npu-ius-lab/open32drone/docs/project/third-party.md

# Third-party notices

Original Open32Drone code and documentation use **Apache License 2.0** by default. See [LICENSE](../../LICENSE) for the full terms and [LICENSE.txt](../../LICENSE.txt) for the scope. Third-party code, dependencies and media retain their original licenses and copyright notices.

## Software and dependencies

| Component | Source and license |
|---|---|
| Flight-control core | Derived from Oleg Kalachev's [Flix](https://github.com/okalachev/flix). |
| ROS 2 driver | MIT; see [ros2/package.xml](../../ros2/package.xml). |
| IMU/SBUS library | FlixPeriph 1.10.4, used under its upstream license; fetched as a build dependency and not bundled with this repository. |
| MAVLink communication | MAVLink Arduino 2.0.25 and ROS MAVROS, each under its own license. |
| Development tools and runtime dependencies | Arduino-ESP32, Android/Gradle, Vue/VitePress, PyTorch and Isaac Sim, each under its own license. |

## Hardware resource pages

| Resource | Source and license information |
|---|---|
| Frame print profile | [MakerWorld](https://makerworld.com.cn/zh/models/2922108-open32drone-wu-ren-ji-8520kong-xin-bei-ji-jia-ros2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): the page lists CC BY-NC 4.0. Retain attribution and follow the model's terms. |
| PCB design | [JLC Open Hardware](https://oshwhub.com/fanchewang/open32drone): the page lists MIT License and also includes platform notices about redistribution and non-commercial use. Check the project files and platform terms before use. |
