npu-ius-lab/open32drone/docs/index.md

---
layout: doc
aside: false
prev: false
next: false
pageClass: documentation-index
title: 文档与更新
description: Open32Drone 制作教程、开发参考和公开仓库更新记录。
---

<script setup>
import DocumentationHome from './.vitepress/theme/components/DocumentationHome.vue'
</script>

<DocumentationHome />
