npu-ius-lab/open32drone/hardware/assets/pwa-1.4x4x4-screws-12pcs.png

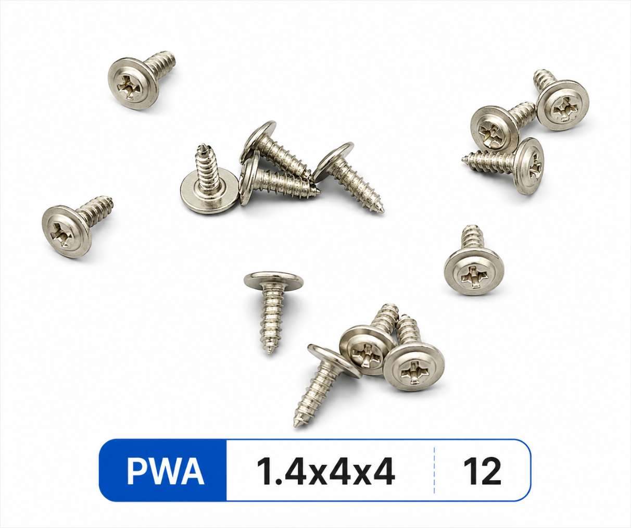
hardware/assets/pwa-1.4x4x4-screws-12pcs.png
