npu-ius-lab/open32drone/hardware/3d-model/open32drone-frame.stp

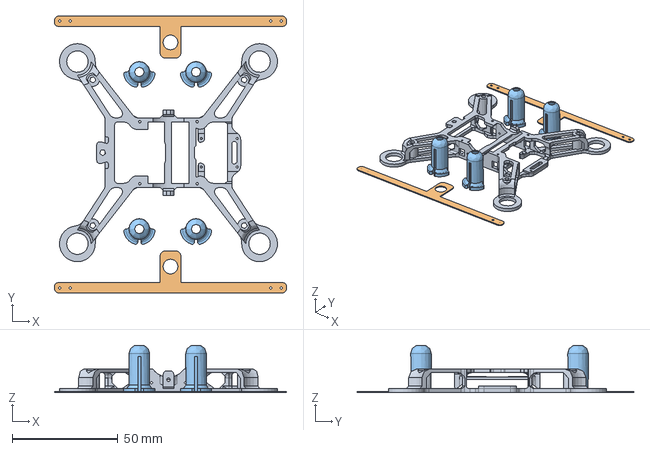
[picture p36: CAD file, 2026-09-30]
hardware/3d-model/open32drone-frame.stp
110.0 x 131.2 x 22.3 mm
