npu-ius-lab/open32drone/(list of files, cad)

Other CAD files:
hardware/3d-model/open32drone-frame.3mf
