npu-ius-lab/open32drone/docs/guide/07-rl.md

# 06 · 强化学习

上一章通过 ROS 读取飞机状态、发送控制目标，再根据传感器反馈调整动作。这一章在仿真中练习强化学习，让策略经过反复训练，学习应对风扰、动力差异和模型误差。

本项目采用残差强化学习：几何 PD 控制器负责稳定姿态、分配四路电机输出，PPO 网络给出三轴加速度修正。对于这架 81 g 的微型飞机，这样安排可以保留基础控制器中明确的物理关系，让策略主要学习传统模型难以描述的扰动和误差。

## 6.1 先把真实飞机变成机器人模型

仓库中的数值模型和 PPO 练习可以直接运行，但不包含完整飞机的 URDF/USD 场景、Gazebo 飞行后端和预训练权重。下面用参考结构和仿真视频说明建模方式，曲线也来自仿真。没有另外准备场景时，从 6.4 的 CPU 练习开始，不要直接执行 Isaac 命令。

参考 URDF/USD 模型使用一个刚性机身和四个旋翼关节：

参考模型层级

`base_link` 包含不会相对机身运动的主体：打印机架、主控 PCB、XIAO、橡胶圈、电机外壳、供电与固定结构。IMU 和光流/ToF 都有固定坐标系，方便 ROS 和仿真传感器引用；它们的实体质量已计入刚性机身。电池单独保留 `battery_link`，便于更换质量或位置；相机也是固定 link；四副桨叶各自是一个 `continuous` link。

参考模型的质量分配为：

| 部分 | 质量 |
| --- | ---: |
| 刚性机身 `base_link` | 54.2547 g |
| 4 副桨叶 | 约 1.4542 g |
| 18350 电池 | 25.0000 g |
| 相机 | 约 0.2911 g |
| 合计 | 81.0000 g |

下面的视频把四段 Isaac Sim 检查合在一起：外观与 81 g 配置、主控 PCB 近景、无动力自由落体、四个旋翼关节运动。

<video class="guide-video" controls preload="metadata" playsinline poster="/media/figures/model-checks-poster.png">
  <source src="/media/videos/model-checks.mp4" type="video/mp4">
</video>

## 6.2 没有完整电机曲线，怎样先建立模型

8520 电机只给出尺寸和最高 50,000 rpm，不能直接得到带 60 mm 桨时的推力。最高转速换算为角速度是：

```text
50,000 × 2π ÷ 60 = 5,235.99 rad/s
```

这个数可以用来设置关节速度上限，但不能当作实际带桨转速或推力。可以先根据真实飞机悬停时的受力估算：

```text
单电机平均悬停推力
= 总质量 × 重力加速度 ÷ 4
= 0.081 kg × 9.80665 m/s² ÷ 4
≈ 0.1986 N
≈ 20.25 gf
```

再从记录了电压的日志中，读取稳定悬停时四路电机命令的平均值。参考日志约为 47.4%，粗模型据此外推，得到满命令时约 0.419 N/电机的推力，并取 40 ms 作为电机响应初值。训练时随机改变推力增益、质量、惯量、电压和响应时间，避免策略过度依赖某一组固定参数。

这些粗估值可以先用于训练、评估和 Isaac 展示，不必等厂家提供完整模型。后续可以搭一个简单的单电机推力台，在 4.2、3.9、3.7、3.5 V 下测量多个 PWM 点，再逐步用实测数据替换。

## 6.3 训练任务是什么

悬停练习的观测有 35 维，包含位置/速度误差、姿态矩阵、角速度、参考速度与加速度、上一步动作、误差积分、电机估计力和电压。网络输出 3 维动作，分别是 x、y、z 方向的残差加速度，范围为 `±4 m/s²`。

每个仿真环境都从略有不同的初始姿态、动力参数和风扰开始。策略在每一步得到奖励：

- 接近目标位置与速度；
- 保持姿态和飞行高度；
- 动作平滑，不频繁大幅修正；
- 不发生翻覆、撞地或飞出范围。

PPO 会同时运行多个仿真环境，收集观测、动作和结果，再用这些数据更新策略。训练结束后，换用训练时未见过的随机种子和更强的扰动，比较基础 PD 与 PPO 残差的表现。

## 6.4 在普通电脑上跑第一个 PPO

从仓库根目录创建 Python 环境：

```bash
python3 -m venv .venv
source .venv/bin/activate
python3 -m pip install --upgrade pip
python3 -m pip install numpy torch matplotlib
```

运行 CPU 悬停练习：

```bash
python3 simulation/course/hover_lab.py \
  --output output/my-first-hover \
  --iterations 400 --envs 128 --device cpu
```

输出目录会包含：

| 文件 | 内容 |
| --- | --- |
| `training.csv` | 每轮奖励、位置误差和失败数 |
| `policy_initial.pt` / `policy_final.pt` | 初始与最终策略 |
| `actor.pt` | 可独立加载的 TorchScript 策略 |
| `evaluation.json` | PD 与 PPO 在留出工况中的结果 |
| `config.json` | 训练使用的全部设置 |

参考运行的结果如下，数值是 96 个完整回合的平均 RMS 位置误差：

| 水平扰动 | 基础 PD | PPO 残差 |
| ---: | ---: | ---: |
| 0.0 m/s² | 1.58 cm | 3.64 cm |
| 0.8 m/s² | 16.51 cm | 6.03 cm |
| 1.5 m/s² | 30.48 cm | 10.56 cm |

这次参考运行中，平静环境下的基础 PD 更准确；风扰增强后，PPO 的补偿明显降低了位置误差。残差策略主要处理持续扰动和模型误差，稳定飞行仍由基础控制器负责。

基础 PD 与 PPO 在三种扰动下的位置误差

<p class="figure-caption">图 7-1　CPU 悬停练习的留出工况对比。</p>

PPO 训练曲线

<p class="figure-caption">图 7-2　训练过程中的奖励与误差变化。</p>

## 6.5 从悬停到技巧飞行

除了定点悬停，演示中还安排了连续轨迹：先沿八字曲线穿过 10 个环，再螺旋爬升，最后在阵风中悬停。目标轨迹由程序给出，PPO 负责学习轨迹跟踪和扰动补偿。

先看相同扰动下的固定镜头悬停。第一段是基础 PD，第二段是 PPO 残差：

<div class="video-grid">
  <figure>
    <video class="guide-video" controls preload="metadata" playsinline poster="/media/figures/hover-pd-poster.png">
      <source src="/media/videos/hover-pd.mp4" type="video/mp4">
    </video>
    <figcaption>基础 PD：受到持续扰动后出现较大的稳态偏移。</figcaption>
  </figure>
  <figure>
    <video class="guide-video" controls preload="metadata" playsinline poster="/media/figures/hover-ppo-poster.png">
      <source src="/media/videos/hover-ppo.mp4" type="video/mp4">
    </video>
    <figcaption>PPO 残差 + PD：策略主动补偿扰动并回到目标附近。</figcaption>
  </figure>
</div>

下面是 60 秒完整演示，包括模型、训练流程、悬停对照、八字穿环、螺旋和阵风恢复：

<video class="guide-video" controls preload="metadata" playsinline poster="/media/figures/rl-demo-poster.png">
  <source src="/media/videos/rl-demo-60s.mp4" type="video/mp4">
</video>

Isaac Sim 中的 34 秒连续飞行通过了 10/10 个环，位置 RMS 误差约 12.11 cm，最高速度约 1.10 m/s。独立工况对比如下：

| 工况 | 基础 PD | PPO 残差 + PD |
| --- | ---: | ---: |
| 平静 | 2.72 cm | 8.19 cm |
| 持续扰动 | 51.33 cm | 18.43 cm |
| 电机差异与质量误差 | 53.81 cm | 14.28 cm |
| 突变阵风 | 34.46 cm | 26.92 cm |

## 6.6 数值训练与可选 Isaac Sim

数值训练不需要外部场景。运行本节最后的 Isaac 命令时，需要自行准备兼容的 USD 资产，目录内应包含 `USD/open32droe/robot.usd` 及其引用资源。运行前把示例路径替换为自己的资产目录。

完整训练脚本使用 CUDA。先在训练工作站运行物理检查：

```bash
cd /path/to/open32drone/simulation/rl_demo
python3 physics_checks.py \
  --output ../../output/rl-demo/my-run/physics-checks.json
```

然后训练、评估并做赛道预检：

```bash
python3 train.py \
  --output ../../output/rl-demo/my-run \
  --iterations 1200 --envs 1024

python3 evaluate.py --run ../../output/rl-demo/my-run
python3 preflight.py --run ../../output/rl-demo/my-run
```

Isaac Sim 的独立 Python 环境用它自带的 `python.sh` 启动：

```bash
/path/to/isaac-sim/python.sh \
  /path/to/open32drone/simulation/rl_demo/native_isaac.py \
  --package /path/to/open32drone/output/simulation-model/OPEN32DRON_fixed_81g \
  --run /path/to/open32drone/output/rl-demo/my-run \
  --output /path/to/open32drone/output/rl-demo/my-run/native \
  --seconds 34 --record --visible
```

`native_isaac.py` 每 5 ms 向刚体施加四电机合力与力矩，飞机的位置和姿态来自 PhysX 积分；轨迹、环和摄影机用于展示，不会逐帧拖动飞机。

## 6.7 怎样继续走向真机策略

准备尝试真机策略时，还有以下工作要做：

1. 用单电机推力台替换满推力、响应时间和反扭矩初值；
2. 把 IMU、光流和 ToF 的噪声、延迟、丢帧加入训练环境；
3. 将 ROS 记录的状态整理成与策略 35 维观测一致的输入，先做回放推理，再做受限台架与低高度试验。

示例策略使用仿真状态，圆环位置由任务直接给出。下一阶段可以用相机加入视觉定位或目标识别；策略先输出有界加速度或速度修正，通过 ROS 接入现有飞控闭环，待台架数据充分后再研究更底层的执行器控制。

前面的练习涉及硬件建模、飞控、ROS 和数值训练，但完整场景资产、传感器仿真以及策略向真机的迁移，仍需单独准备和验证。

## 6.8 资产坐标与检查顺序

建模统一使用米、千克、秒。机体系采用 ROS FLU（X 前、Y 左、Z 上），接固件接口时
明确转换坐标；不要把 CAD 坐标直接复制为飞控参数。分别检查比例、重心和惯量；
机架文件不包含全部电路、线束、电机和电池质量，应测量装配后的整机。

使用简化碰撞体，避免重叠。先检查比例与质量，再检查重力/接触、旋翼轴和力的符号，
最后闭环仿真。模型参数见 `simulation/rl_demo/model.json`，不是自动标定值。
适配器读取的相对路径为 `USD/open32droe/robot.usd`，资产目录需与该路径一致。
换场景时核对引用的网格、材质和所用 Isaac 版本；传感器仿真、固件在环、Gazebo 接入
及 sim-to-real 各自需要独立实现和验证。
