npu-ius-lab/open32drone/docs/guide/05-tuning.md

# 04 · 飞行调参

调参前，先观察飞机有什么问题，检查机械、传感器和供电状态。每次只改一个值，用同样的动作短飞一次，再比较前后的表现。连续做两三次对比，更容易判断变化来自哪里。

## 4.1 先判断是不是参数问题

出现下面这些现象时，先检查硬件：

| 现象 | 先检查 |
| --- | --- |
| 起飞瞬间向一侧翻倒 | M0–M3 位置、转向、CW/CCW 桨、IMU 朝向 |
| 某一侧始终无力 | 桨叶损伤、电机弯轴、接头、电机温度与电池压降 |
| 高频细碎振动 | 桨叶变形、电机轴、橡胶圈、电机高度、IMU 固定 |
| 定点只在某种地面失效 | 地面纹理、反光、光照、光流窗口 |
| 高度值跳变 | ToF 窗口、模块倾斜、近距离盲区和线束 |
| 换电以后重心变化 | 电池位置、附件位置和实际起飞重量 |

机械状态稳定后，用同一块电池、同一处地面和同一高度做对比。首选的测试动作是“0.65 m 起飞 → 回中悬停 5 秒 → 降落”。

## 4.2 认识四层控制

调参时，从内环到外环依次检查：

从内环到外环调参

先调稳内环，再调外环。P 决定纠正误差的力度，I 用来消除持续偏差，D 抑制变化过快造成的过冲。通常先看 P，再看 I，确有需要时才调整 D。

查看所有参数：

```text
p
```

查看或写入单个参数：

```text
p CTL_R_P
p CTL_R_P 4.02
```

::: warning 修改前先保存原参数
写入会保存到 NVS，重启不会恢复原值。改之前用 `p` 保存当前参数，**每次只改一个值**，改完等待一秒再读取确认。飞行表现变差时，写回原值。
:::

## 4.3 姿态抖动与回正

更换桨叶后，要重新检查原来的 PID 是否合适。桨叶的直径、螺距和重量会影响推力与电机响应，即使直径相同，不同型号也可能需要不同的参数。先确认桨叶、电机和供电匹配，再用短飞日志比较，具体方法见[用日志比较两次飞行](#_4-7-用日志比较两次飞行)。

标准姿态参数如下：

| 功能 | Roll | Pitch | 默认值 |
| --- | --- | --- | ---: |
| 角度 P | `CTL_R_P` | `CTL_P_P` | 4.47 |
| 角速度 P | `CTL_R_RATE_P` | `CTL_P_RATE_P` | 0.05 |
| 角速度 I | `CTL_R_RATE_I` | `CTL_P_RATE_I` | 0.20 |
| 角速度 D | `CTL_R_RATE_D` | `CTL_P_RATE_D` | 0.001 |

### 高频抖动

如果飞机能起飞，但机身快速、连续地抖动，先修复桨和电机振动。机械正常后，将对应轴的角速度 P 降低 5–10%。例如 Roll 从 `0.050` 改为 `0.045`：

```text
p CTL_R_RATE_P 0.045
```

重新做同样的 5 秒悬停。抖动减轻且控制仍有力度，再在 Pitch 轴按同样幅度处理；不要一次同时改 P、I、D。

### 慢速来回摆动或回正过猛

低频、大幅度摆动更可能来自外层角度 P。把 `CTL_R_P` 或 `CTL_P_P` 降低约 10%，例如 `4.47 → 4.02`。如果飞机显得反应迟钝、松杆后很久才回平，可向原值方向小幅增加。

### 持续偏向一侧

飞机持续向同一方向倾斜，通常要检查重心、电机出力、机架变形或加速度计偏置。先移动电池让重心回到中央，再重新运行 `ca`。确认机械状态和校准都正常后，如果仍反复出现相同偏差，再分析 I 项。

## 4.4 高度问题

高度控制的主要参数是：

| 参数 | 默认值 | 作用 |
| --- | ---: | --- |
| `ALT_P` | 0.747 | 高度误差的主要纠正力度 |
| `ALT_I` | 0.10 | 消除长期高度偏差 |
| `ALT_D` | 0.20 | 根据垂直速度抑制过冲 |
| `ALT_HOVER` | 0.49 | 标称悬停推力前馈 |
| `ALT_VEL_MAX` | 0.45 | 最大升降速度 |

飞机围绕目标高度缓慢上下摆动时，先确认 ToF 数据连续，再把 `ALT_P` 降低约 10%，例如：

```text
p ALT_P 0.67
```

起飞后姿态稳定，但高度逐渐偏低或偏高，可以检查 `ALT_I` 并小幅调整。接近目标高度时明显冲过头、随后又反向移动，则重点观察 ToF 速度和 `ALT_D`。

`ALT_HOVER` 表示标准电压附近维持高度所需的集体推力。81 g、60 mm 桨的参考值是 0.49。如果传感器正常、姿态平稳，飞机却一直需要较大的高度修正量才能悬停，可以从飞行日志估计悬停时的电机输出均值，再小幅调整。不要用提高 `ALT_HOVER` 掩盖电池老化或电机出力不足。

## 4.5 水平漂移与定点

定点控制依赖光流，默认参数为：

| 参数 | 默认值 | 作用 |
| --- | ---: | --- |
| `POS_HOLD_P` | 0.85 | 位置误差转换为目标速度 |
| `POS_VEL_P_X/Y` | 0.35 | 水平速度 P |
| `POS_VEL_I_X/Y` | 0.04 | 水平速度 I |
| `POS_STICK_V` | 0.70 | 摇杆最大水平速度 |

先在纹理清晰的地面上运行 `flow`，确认数据持续更新。原地偏航时如果位置沿圆周漂移，检查模块是否安装在标准的前移 24 mm 位置，以及安装平面是否水平。持续向固定方向漂移时，重新检查光流零偏、电池重心和 IMU 校准。

飞机慢慢偏离目标、回位缓慢，可以小幅增加 `POS_HOLD_P`；围绕目标左右来回摆动，则小幅降低。一次改 5–10%，每次使用相同的定点高度和飞行时间。

## 4.6 电池与动力变化

参考电池满电约 4.2 V，放电过程中电机可用推力会下降。主板通过 `GPIO1/A0` 读取 100 kΩ / 100 kΩ 分压后的电压，辅助定高和定点使用有界前馈补偿。

先用 `pw` 和万用表把 `PWR_VOLT_SCALE` 校准准确。新电池和低电量电池各做一次同样的 5 秒悬停，比较日志里的 `voltage`、`hoverFF`、`voltComp` 和四路电机输出。如果电压下降时四路同时接近饱和，优先检查电池内阻、桨叶和电机，而不是继续提高 PID。

## 4.7 用日志比较两次飞行

飞行结束、落地上锁且电机停转后，在串口终端（如 CoolTerm）中运行，查看飞行日志：

```text
log dump
```

::: warning 导出前不要断电、重启或再次解锁
当前固件以 **25 Hz** 记录解锁期间的数据，内存环形缓冲只保留**最近约 12 秒**。上锁后停止记录，重新解锁会清空上一段日志，断电或重启也会丢失。若连接 USB 或打开串口导致重启，就无法再导出刚才的飞行记录。解锁状态下执行 `log dump` 会被拒绝。
:::

把完整串口输出另存一份，再整理出分析用的 `flight.csv`：保留以 `t,rates.x,...` 开头的表头及后面的数值行，删除命令回显、`Log samples: ...` 和其他提示文字。表头必须与数据一起保留，`t` 的单位为秒。另用 `p` 保存这次飞行使用的参数。

可用仓库中的脚本检查 CSV 数据，并生成电压、电机输出和采样间隔的统计摘要：

```bash
python3 simulation/course/analyze_log.py \
  --csv /path/to/flight.csv \
  --output output/my-flight-analysis
```

脚本输出 `log-summary.json`，不会自动绘制全部曲线或计算 PID。分析姿态、高度和定点响应时，可用绘图工具，也可以把 CSV 交给能读取文件和绘图的 AI 工具辅助分析。

至少比较以下曲线或字段：

- 姿态目标与实际 Roll/Pitch；
- ToF 高度与高度目标；
- 光流速度与位置误差；
- 四路电机输出及其是否饱和；
- 电池电压和补偿量；
- 问题发生前后的时间点。

### 用 AI 辅助分析和调参

把飞行 CSV、`p` 的参数输出和实际使用的固件版本一起提供给 AI，并注明桨叶型号、直径、螺距（已知时）、电机、电池、起飞重量、飞行模式，以及什么时候出现了抖动或漂移。换桨前后的两份日志尤其适合放在一起比较。

可以这样描述任务：

> 这是 Open32Drone 的飞行日志和当前参数，桨叶及机体配置见附件说明。请先检查日志是否完整、传感器是否有效、电压是否异常，再绘制目标与实际姿态、角速度、高度和电机输出。结合我标注的异常时段，区分机械振动、动力不足和控制参数不合适的可能原因。需要调参时，请使用参数表中实际存在的名称，说明依据、优先调整的一个参数、小幅修改建议，以及下一次短飞应观察什么。证据不足时指出还缺什么数据。

::: tip 用日志验证调参建议
AI 可以帮助找出异常时段、比较曲线和提出 PID 或悬停推力参数的调整建议，**建议值仍需逐项短飞验证**。当前日志只有 25 Hz，不能据此可靠判断高频振动，也不能从一次悬停直接算出一套适用于所有桨叶的 PID。一次只改一个值，保留原值和前后日志。
:::

每次调参记下原参数、修改值、飞行动作和观察结果，对比时使用相同动作。变好就保留并继续小幅调整，变差就恢复旧值。把这些记录留好，之后就能查到这台飞机用过哪些参数、效果如何。

飞机能重复完成定点起飞、5–10 秒悬停、小范围平移和自动降落后，就可以开始 ROS 控制实验。

## 4.8 按错误提示排查

## 启动与预检失败

### 没有串口输出，或 LED 只闪一下

1. 确认在 `0x0` 写入的是完整 merged 镜像，而不是只用于 OTA 的 app 镜像；
2. 使用正确的 ESP32-S3 USB 端口和 115200 波特率；
3. 完整擦除后再通过 USB 刷写一次；
4. 查看启动日志中的分区、反复复位或欠压信息。

### 初始化完成后 GPIO21 一直闪烁

执行 `pw`，并用万用表核对。滤波电压不高于 `3.10 V` 并持续 `1.5 s` 后进入 `2 Hz`
闪烁；只有电压不低于 `3.20 V` 并持续 `1.0 s` 才退出。闪灯只做提示，不会自动降落或
上锁。不带分压电路的旧板应设置 `PWR_VOLT_PIN=-1`，不能让悬空 ADC 保持启用。

### `motor PWM unavailable`

说明四路 LEDC 电机通道没有全部 attach 成功，不能绕过预检。确认固件使用固定版本的
Arduino-ESP32 core 构建；相机或其他模块没有占用相同 LEDC 资源；电机引脚按左后、
右后、右前、左前对应 `4, 3, 6, 5`。

### `gyro calibration incomplete`

把飞机放在刚性水平面上冷启动，至少两秒不要触碰。仍不能完成时，用 `imu` 查看失败
原因和标准差，排除振动、气流、桌面晃动和损坏电机。`cg` 只重新开始陀螺校准，不能
代替 `ca`。

### `invalid RC calibration/mapping`

给接收机供电，运行 `cr` 并完成八步提示。每个控制量必须映射到互不重复、可持久化的
`0..7` 通道。使用 Android 或 ROS 时不要求接收机开机。

### 参数存储错误

如果 `sys` 显示 `Parameter storage: ERROR`，固件会拒绝解锁。不能带着无法保存的校准
继续飞。完整擦除、重刷并重新执行 `ca`/`cr`；若再次出现，应排查 Flash/NVS 硬件和
分区。

### 循环频率低或不稳定

不能因为一个 `rate` 数字就删除安全检查或关闭飞行日志；正常结果应接近固定 300 Hz。
上锁后执行 `perf reset`，保持一种负载运行 10-20 秒，再保存 `time` 和 `perf`。飞机单独、
Android、ROS、QGC 参数页要分别测试。比较截止时间错过次数、最大迟到量、p95/p99/最大
时延和各命名阶段耗时。`imu acquire` 是选定后端执行 `read()` 的成本；不同传感器系列的
驱动内部可能还有自己的传输。固定节拍的主动等待有意不计入 `perf`，因此抽样总耗时是
实际执行成本，不是完整 3.33 ms 周期。CLI、MAVLink 或后台阶段最大值很大时才指向对应
路径。25 Hz 日志保存在 RAM 环形缓冲中；排查日志开销时，查看后台阶段的耗时统计。

## TF-0850 与校准

### 飞机放在地面，Android 提示 ToF 未就绪

TF-0850 约 `20 mm` 以下属于盲区。固件允许使用新鲜的盲区数据包完成地面传感器检查，但不会
显示无效距离。Android 的这条提示本身不会阻止起飞。按钮不可用时应排查
MAVLink 连接或物理 SBUS 控制权。

执行 `flow`，确认：

- `TOF UART healthy: 1`；
- 数据年龄小于 `150 ms`；
- 有数值距离或 `blind-zone: 1`；
- 数据包计数持续增加。

### 加速度计校准被拒绝

拆桨、上锁状态运行 `ca`，按提示依次放置六个面，并在采样期间保持静止。任一面的采样不稳定或计算结果不合格，本次校准就不会保存，
仍使用之前的参数。

### 相同套件装出的飞机表现不同

使用相同机架、电机和桨叶的飞机，可以从同一套默认控制参数开始。不同飞机表现不一致时，先检查机械安装和 `ca`/`cr` 校准，不能用隐藏的 Trim 补偿掩盖问题。更换桨叶或动力配置后，再按前面的日志方法复核参数。逐项核对：

- 电机/桨叶型号与方向；
- 弯轴、松动机臂或电机高度不一致；
- IMU 刚性固定并与推力平面平行；
- 电池位置与重心；
- 向下模块方向和标准 `24 mm` 前向偏置；
- 校准平面与振动。

当前固件没有自动配置迁移或悬停 Trim 学习功能，不会通过这些方式改写复制过来的控制参数。

## Android 链路与控制

### `ENETUNREACH (Network is unreachable)`

手机没有到所配置飞机地址的 Wi-Fi 路由，或 Android 重建了该路由。直连 AP 模式下，
手机连接飞机 SSID，地址保持 `192.168.4.1`；路由器 STA 模式下，手机连接同一路由器，
并把固件 `wifi` 命令打印的 DHCP 地址填入 **工具 > 飞机地址**。关闭 VPN、授予局域网
权限，并用浏览器访问：

```text
http://<飞机地址>:8080/api/ota/status
```

客户端会把 MAVLink、图传和 OTA 绑定到能够到达所配置地址的 Android Wi-Fi 网络；
旧 socket 失效后会关闭，并在该路由恢复后重连，不会退回蜂窝网络。

### 按钮全部是灰色

查看顶部状态：

- 未连接：没有 MAVLink 心跳；
- 物理 SBUS 优先：松开摇杆等待控制权空闲；若只用 Android，也可关闭接收机；
- App 进入后台：回到前台，进入后台会有意停止手动控制流。

Android 控制不需要先打开物理遥控器。

### 起飞后约几秒自动降落

常见原因是手机停止更新控制指令、Wi-Fi 路由发生变化，或旧客户端在起飞后发出了过期的零油门帧。使用匹配的 APK/固件，让 App 保持前台，并检查状态文本中的 `link loss`。应先解决连接问题，不要通过延长失联时间绕过保护。

## ROS 2 连接与命令

### 有话题名字但没有数据

节点可以在飞控未连接前创建话题。检查：

```bash
ping -c 3 <飞机地址>
ros2 run open32drone_driver control status
ros2 topic echo /open32drone/connected --once
```

飞机直连 AP 使用 `192.168.4.1`；STA 模式启动 ROS 时传入同一 DHCP 地址：
`aircraft_ip:=<飞机地址>`。

关闭控制这架飞机的 Android 和其他客户端，并确认所选 `local_udp_port` 没有被其他
MAVROS 进程占用。`connected: false` 的旧
`/open32drone/UAS1/state` 样本不代表连接成功。

### `rqt` 报 QoS 不兼容

订阅 Reliable 公共桥接话题 `/open32drone/imu/data`、`/open32drone/odom`、
`/open32drone/pose`、`/open32drone/range/downward`，不要直接用 MAVROS
sensor-data 话题。仍有告警时，确认启动的是完整
`open32drone.launch.py`，且 `interface_bridge` 正在运行。

### `/open32drone/cmd_vel` 没反应

飞机必须已连接、解锁、位姿新鲜并进入 Offboard ACTIVE。先使用 `control velocity`，
并查看：

```bash
ros2 topic echo /open32drone/offboard/status
ros2 topic echo /open32drone/flight/status
```

直接向 `/open32drone/cmd_vel` 发布速度时，必须连续发送；物理 SBUS 动作优先。Offboard 尚未激活时，调整固件增益也不会让速度指令生效。

## OTA 失败

只有飞机已上锁、已落地、电机停止、自动飞行和 Offboard 均未激活，并且当前镜像已
通过启动验证时才接受 OTA。只能上传 app 镜像，不能上传 USB merged 镜像。查看：

```text
http://<飞机地址>:8080/api/ota/status
```

始终保留 USB 恢复条件。传输失败应保留当前运行分区；新镜像启动验证失败应自动回滚。
