npu-ius-lab/open32drone/docs/project/changelog.md

---
title: Changelog
outline: false
---

<script setup>
import UpdateList from '../.vitepress/theme/components/UpdateList.vue'
</script>

# Changelog

Selected updates to the flight controller, control apps, development tools and documentation.

<UpdateList english />

See [Releases](https://github.com/npu-ius-lab/open32drone/releases) for software downloads.
