npu-ius-lab/open32drone/docs/project/changelog.zh-CN.md

---
title: 更新日志
outline: false
---

<script setup>
import UpdateList from '../.vitepress/theme/components/UpdateList.vue'
</script>

# 更新日志

记录飞控、控制端、开发工具与教程的重要更新。

<UpdateList />

软件下载见 [Releases](https://github.com/npu-ius-lab/open32drone/releases)。
