npu-ius-lab/open32drone/firmware/estimate.ino

// Copyright (c) 2023 Oleg Kalachev <okalachev@gmail.com>
// Repository: https://github.com/okalachev/flix

// Attitude estimation from gyro and accelerometer
// estimateHeight(): 光流高度融合（加速度积分 + TOF 修正）

#include "quaternion.h"
#include "vector.h"
#include "lpf.h"
#include "util.h"

Vector rates; // estimated angular rates, rad/s
Quaternion attitude; // estimated attitude
Vector attitudeEuler; // derived once per IMU sample and reused by control/telemetry
Vector attitudeBodyUp(0, 0, 1);
bool landed;
bool heightEstimateValid = false;
bool flightGroundConfirmed = false;

float accWeight = 0.003;
float levelWeight = 0.0002f; // retained parameter name: gated in-flight gravity correction weight
LowPassFilter<Vector> ratesFilter(0.2); // cutoff frequency ~ 40 Hz
bool flightAccCorrectionActive = false;
float accFilteredNorm = ONE_G;

extern uint32_t opticalFlowSequence;
extern uint32_t opticalFlowTimestamp;
extern float opticalFlowSampleDt;
extern uint32_t tofSequence;
extern uint32_t tofTimestamp;
extern float tofSampleDt;
extern bool armed;
extern bool assistedTakeoffGroundIdle;
extern bool flightWasAirborne;
extern bool imuHealthy, blindDescentActive, tofRangeInBlindZone;
extern uint32_t imuLastSampleMs;

void estimate() {
	applyGyro();
	applyAcc();
	if (attitude.valid()) {
		attitudeEuler = attitude.toEuler();
		attitudeBodyUp = Quaternion::rotateVector(Vector(0, 0, 1), attitude);
	} else {
		attitudeEuler.invalidate();
		attitudeBodyUp.invalidate();
	}
}

void applyGyro() {
	// filter gyro to get angular rates
	rates = ratesFilter.update(gyro);

	// apply rates to attitude
	attitude = Quaternion::rotate(attitude, Quaternion::fromRotationVector(rates * dt));
}

void updateFlightGroundState() {
	static Delay contactDelay(0.30f);
	static bool flightCommanded = false;
	static double nearGroundTime = 0.0;
	// This runs for EVERY mode, including direct Offboard attitude control.
	if (armed && thrustTarget > 0.12f) {
		assistedTakeoffGroundIdle = false;
		flightCommanded = true;
	}
	bool rangeFresh = tofRangeFresh();
	float groundRange = autoFlightGroundRange > FLOW_SENSOR_MIN_HEIGHT ? autoFlightGroundRange : 0.05f;
	if (armed && rangeFresh && opticalFlowHeight > groundRange + 0.08f) {
		flightWasAirborne = true;
		assistedTakeoffGroundIdle = false;
		flightCommanded = true;
	}
	bool resting = imuHealthy && imuLastSampleMs != 0 && millis() - imuLastSampleMs <= 50 &&
		acc.valid() && rates.valid() &&
		abs(acc.norm() - ONE_G) < ONE_G * 0.20f && rates.norm() < radians(20.0f);
	bool idle = !flightCommanded && (!armed || assistedTakeoffGroundIdle);
	bool descending = !armed || rcFailsafeActive || blindDescentActive ||
		autoFlightPhase == AUTO_LAND_DESCEND || autoFlightPhase == AUTO_LAND_FLARE ||
		(mode == STAB && controlThrottle < 0.05f);
	bool nearGround = rangeFresh && opticalFlowHeight <= groundRange + 0.012f;
	if (!armed || !descending) nearGroundTime = 0.0;
	else if (nearGround) nearGroundTime = t;
	bool blindPacket = tofPacketFresh() && tofRangeInBlindZone;
	// Invalid zeros at altitude are not contact. Only bridge a short blind-zone
	// transition after an actual near-ground measurement during descent.
	bool blindContact = blindPacket && nearGroundTime > 0.0 && t - nearGroundTime < 1.0;
	bool contact = (nearGround || blindContact) && abs(velocity.z) < 0.15f &&
		thrustTarget < altitudeHoverFeedForward() * 0.80f && descending;
	// After an explicit stop, fresh blind-zone packets plus sustained IMU rest
	// can recover the ground state. Complete sensor loss cannot do so.
	bool disarmedBlindRest = !armed && !motorsActive() && blindPacket;
	flightGroundConfirmed = contactDelay.update(resting && (idle || contact || disarmedBlindRest));
	if (flightGroundConfirmed && !armed) flightCommanded = false;
}

void applyAcc() {
	accFilteredNorm = acc.norm();
	// Idle spin alone is not flight, but commanded lift must immediately disable
	// the strong ground correction, including direct Offboard attitude control.
	updateFlightGroundState();
	landed = flightGroundConfirmed;
	bool flightAccReliable = motorsActive() && thrustTarget >= 0.1f &&
		abs(accFilteredNorm - ONE_G) < ONE_G * 0.15f &&
		rates.norm() < radians(200.0f);
	flightAccCorrectionActive = !landed && flightAccReliable && levelWeight > 0.0f;
	if (!landed && !flightAccCorrectionActive) return;

	// Correct the estimated gravity direction, not toward an assumed level frame.
	// The in-flight weight is deliberately much weaker than the landed weight.
	Vector up = Quaternion::rotateVector(Vector(0, 0, 1), attitude);
	float weight = landed ? accWeight : levelWeight;
	Vector correction = Vector::rotationVectorBetween(acc, up) * weight;

	attitude = Quaternion::rotate(attitude, Quaternion::fromRotationVector(correction));
}

Vector worldVelocityEstimate() {
	float yaw = attitudeEuler.z;
	return Vector(
		velocity.x * cosf(yaw) - velocity.y * sinf(yaw),
		velocity.x * sinf(yaw) + velocity.y * cosf(yaw),
		velocity.z);
}

// ==================== ToF height estimation ====================
// High prop vibration made vertical accelerometer integration diverge. Keep
// position.z/velocity.z tied to the direct ToF measurement until vibration is
// low enough for a separately validated inertial vertical estimator.
#define FLOW_HEIGHT_MAX_RATE 2.0f
#define FLOW_HEIGHT_JUMP_REJECT 0.45f

void estimateHeight() {
	static uint32_t lastHeightSequence = 0;
	static bool heightValid = false;
	static LowPassFilter<float> verticalSpeedFilter(0.18f);
	bool sampleValid = tofRangeFresh() && opticalFlowHeight > 0.05f && opticalFlowHeight < 6.0f;
	heightEstimateValid = sampleValid;
	bool newHeightSample = sampleValid && tofSequence != lastHeightSequence;

	if (newHeightSample) {
		lastHeightSequence = tofSequence;
		float sampleDt = constrain(tofSampleDt, 0.01f, 0.20f);
		if (!heightValid) {
			position.z = opticalFlowHeight;
			velocity.z = 0.0f;
			verticalSpeedFilter.reset();
			heightValid = true;
			return;
		}

		float heightDelta = opticalFlowHeight - position.z;
		float acceptedDelta = heightDelta;
		if (abs(heightDelta) > FLOW_HEIGHT_JUMP_REJECT) {
			acceptedDelta *= 0.10f;
		}
		float maxStep = max(0.01f, FLOW_HEIGHT_MAX_RATE * sampleDt);
		acceptedDelta = constrain(acceptedDelta, -maxStep, maxStep);
		velocity.z = verticalSpeedFilter.update(acceptedDelta / sampleDt);
		position.z += acceptedDelta;
		return;
	}

	if (!sampleValid) {
		// Match the previous nominal 300 Hz decay, independent of loop load.
		velocity.z *= expf(logf(0.90f) * 300.0f * max(dt, 0.0f));
		if (!motorsActive()) {
			position.z = 0.0f;
			velocity.z = 0.0f;
			heightValid = false;
			lastHeightSequence = 0;
			verticalSpeedFilter.reset();
		}
	}
}

// ==================== 光流水平速度估计（定点数据基础）====================
// 光流体轴速度 → 陀螺补偿 → 偏置自适应 → 世界系速度/位置积分

// Rotation fit for the standard sensor mounting. Optical-flow packets describe
// an integration window that ends before UART delivery, so use delayed rates.
float flowGyroCompPitch = -0.78f;
float flowGyroCompRoll = -0.77f;
float flowGyroDelayMs = 40.0f;
float flowVelocitySmoothing = 0.20f;
float flowInnovationLimit = 0.8f;
float flowTiltCosMin = 0.85f; // keep flow available throughout the global 30-degree attitude envelope
float flowBiasAdapt = 0.02f;
float flowVelocityZeroDeadband = 0.03f;
float flowPositionZeroDeadband = 0.015f;
float flowSpikeRejectVelocity = 2.5f; // sensor sanity threshold, not a commanded speed limit
float flowArmMinThrottle = 0.12f;
float flowStationaryGyro = radians(8.0f);
// The combined flow/ToF module is mounted 24 mm ahead of the yaw center.
// During yaw the sensor moves sideways even when the aircraft center does not.
constexpr float FLOW_SENSOR_FORWARD_OFFSET_M = 0.024f;

Vector flowRawBodyVel;
Vector flowGyroBodyVel;
Vector flowCompBodyVel;
Vector flowFilteredBodyVel;
Vector flowBias;
Vector flowInnov;
Vector rawBodyVel;
bool flowStationary = true;
bool flowAirborne = false;
bool flowBiasReady = false;
bool flowBiasFallbackActive = false;
uint32_t flowBiasSamples = 0;
bool flowCtrlZeroLocked = true;
bool flowCtrlUsingFlow = false;
bool flowPositionGateOpen = false;
int flowRejectReason = 0;

float median3(float a, float b, float c) {
	return max(min(a, b), min(max(a, b), c));
}

void estimateHorizontalVelocity() {
	struct TimedRates {
		uint32_t timestamp;
		Vector value;
	};
	constexpr int RATE_HISTORY_SIZE = 64;
	static TimedRates rateHistory[RATE_HISTORY_SIZE];
	static int rateHistoryWrite = 0;
	static int rateHistoryCount = 0;
	static Delay airborneDelay(0.25f);
	static Vector ctrlAnchor;
	static bool ctrlAnchorValid = false;
	static uint32_t lastProcessedSequence = 0;
	static bool flowRecentlyUsable = false;
	static Vector flowHistory[3];
	static int flowHistoryCount = 0;
	static int flowHistoryIndex = 0;

	uint32_t now = millis();
	rateHistory[rateHistoryWrite].timestamp = now;
	rateHistory[rateHistoryWrite].value = rates;
	rateHistoryWrite = (rateHistoryWrite + 1) % RATE_HISTORY_SIZE;
	if (rateHistoryCount < RATE_HISTORY_SIZE) rateHistoryCount++;

	Vector up = attitudeBodyUp;
	bool sampleFresh = opticalFlowHealthy && opticalFlowSequence != 0 &&
		(now - opticalFlowTimestamp <= 150);
	bool tiltRejected = abs(up.z) < flowTiltCosMin;
	bool heightRejected = opticalFlowHeight <= 0.05f;
	bool flowAvailable = sampleFresh && !heightRejected && !tiltRejected;
	// Height is only checked for sensor validity. There is no position-hold
	// engagement altitude or commanded flight-height limit.
	bool airborneCandidate = armed && thrustTarget > flowArmMinThrottle &&
		sampleFresh && !heightRejected && (opticalFlowHeight > 0.08f || velocity.z > 0.03f);
	flowAirborne = airborneDelay.update(airborneCandidate);
	bool newSensorSample = sampleFresh && opticalFlowSequence != lastProcessedSequence;
	bool newFlowSample = flowAvailable && newSensorSample;
	bool flowSpikeRejected =
		abs(flowCompBodyVel.x) > flowSpikeRejectVelocity ||
		abs(flowCompBodyVel.y) > flowSpikeRejectVelocity;
	bool stationaryCandidate = false;
	flowRejectReason = 0;

	if (newSensorSample && !tiltRejected && opticalFlowHeight > FLOW_SENSOR_MIN_HEIGHT) {
		lastProcessedSequence = opticalFlowSequence;
		Vector delayedRates = rates;
		if (rateHistoryCount > 0) {
			int oldest = (rateHistoryWrite - rateHistoryCount + RATE_HISTORY_SIZE) % RATE_HISTORY_SIZE;
			delayedRates = rateHistory[oldest].value;
			uint32_t delayMs = (uint32_t)constrain(flowGyroDelayMs, 0.0f, 100.0f);
			uint32_t targetTimestamp = opticalFlowTimestamp > delayMs ? opticalFlowTimestamp - delayMs : 0;
			for (int i = 1; i <= rateHistoryCount; i++) {
				int index = (rateHistoryWrite - i + RATE_HISTORY_SIZE) % RATE_HISTORY_SIZE;
				if ((int32_t)(rateHistory[index].timestamp - targetTimestamp) <= 0) {
					delayedRates = rateHistory[index].value;
					break;
				}
			}
		}
		flowGyroBodyVel.x = delayedRates.y * opticalFlowHeight;
		flowGyroBodyVel.y = -delayedRates.x * opticalFlowHeight;

		// 方向映射（实测推导：光流Y=前向取反、光流X=左向取反；FLU：X=前、Y=左）
		flowRawBodyVel.x = -opticalFlowVelocityY; // 前向速度（+X=机头）
		flowRawBodyVel.y = -opticalFlowVelocityX; // 左向速度（+Y=左）
		flowCompBodyVel.x = flowRawBodyVel.x - flowGyroCompPitch * flowGyroBodyVel.x;
		// v_center = v_sensor - omega x r. With r=(+0.024, 0, 0), yaw
		// contributes +yawRate*0.024 to the sensor's body-left velocity.
		flowCompBodyVel.y = flowRawBodyVel.y - flowGyroCompRoll * flowGyroBodyVel.y -
			delayedRates.z * FLOW_SENSOR_FORWARD_OFFSET_M;
		flowSpikeRejected =
			abs(flowCompBodyVel.x) > flowSpikeRejectVelocity ||
			abs(flowCompBodyVel.y) > flowSpikeRejectVelocity;

		// Do not qualify ground stationarity from the optical-flow mean itself:
		// that mean is the sensor bias being estimated and differs by sensor unit.
		stationaryCandidate =
			!flowAirborne &&
			abs(rates.x) < flowStationaryGyro &&
			abs(rates.y) < flowStationaryGyro &&
			abs(rates.z) < flowStationaryGyro &&
			thrustTarget < flowArmMinThrottle;

		if (stationaryCandidate) {
			if (flowBiasSamples < 30) {
				flowBiasSamples++;
				float sampleWeight = 1.0f / flowBiasSamples;
				flowBias.x += (flowCompBodyVel.x - flowBias.x) * sampleWeight;
				flowBias.y += (flowCompBodyVel.y - flowBias.y) * sampleWeight;
			} else {
				flowBias.x += (flowCompBodyVel.x - flowBias.x) * flowBiasAdapt;
				flowBias.y += (flowCompBodyVel.y - flowBias.y) * flowBiasAdapt;
			}
			flowBiasReady = flowBiasSamples >= 30;
			if (flowBiasReady) flowBiasFallbackActive = false;
		} else if (!flowAirborne && !flowBiasReady) {
			flowBiasSamples = 0;
			flowBias = Vector();
		} else if (flowAirborne && !flowBiasReady) {
			// Some sensors cannot qualify XY flow at the launch surface, so a
			// ground-bias prerequisite would make POS_HOLD impossible forever.
			// Start with zero bias after sustained airborne flow; the normal
			// stationary learner can replace it after landing.
			flowBias = Vector();
			flowBiasSamples = 0;
			flowBiasReady = true;
			flowBiasFallbackActive = true;
		}

		rawBodyVel.x = flowCompBodyVel.x - flowBias.x;
		rawBodyVel.y = flowCompBodyVel.y - flowBias.y;
		if (!flowSpikeRejected) {
			// Rejected samples must not poison the median window used by the next
			// otherwise-valid packet.
			flowHistory[flowHistoryIndex] = rawBodyVel;
			flowHistoryIndex = (flowHistoryIndex + 1) % 3;
			if (flowHistoryCount < 3) flowHistoryCount++;
			if (flowHistoryCount < 3) {
				flowFilteredBodyVel = rawBodyVel;
			} else {
				flowFilteredBodyVel.x = median3(flowHistory[0].x, flowHistory[1].x, flowHistory[2].x);
				flowFilteredBodyVel.y = median3(flowHistory[0].y, flowHistory[1].y, flowHistory[2].y);
			}
		}
	}

	flowStationary = stationaryCandidate || (!flowAirborne && thrustTarget < flowArmMinThrottle * 0.5f);
	flowCtrlZeroLocked = flowStationary || !flowAirborne;

	if (!sampleFresh) {
		flowRejectReason = 2;
	} else if (!flowAvailable) {
		if (!opticalFlowHealthy) flowRejectReason = 2;
		else if (heightRejected) flowRejectReason = 3;
		else if (tiltRejected) flowRejectReason = 4;
	} else if (!flowAirborne) {
		flowRejectReason = 5;
	} else if (flowStationary) {
		flowRejectReason = 1;
	} else if (flowSpikeRejected) {
		flowRejectReason = 6;
	}

	if (flowCtrlZeroLocked) {
		if (!ctrlAnchorValid) {
			ctrlAnchor.x = position.x;
			ctrlAnchor.y = position.y;
			ctrlAnchorValid = true;
		}

		velocity.x *= 0.3f;
		velocity.y *= 0.3f;
		if (abs(velocity.x) < flowVelocityZeroDeadband) velocity.x = 0.0f;
		if (abs(velocity.y) < flowVelocityZeroDeadband) velocity.y = 0.0f;

		position.x += (ctrlAnchor.x - position.x) * 0.35f;
		position.y += (ctrlAnchor.y - position.y) * 0.35f;
		if (abs(position.x - ctrlAnchor.x) < flowPositionZeroDeadband) position.x = ctrlAnchor.x;
		if (abs(position.y - ctrlAnchor.y) < flowPositionZeroDeadband) position.y = ctrlAnchor.y;
		return;
	}

	ctrlAnchorValid = false;

	if (!sampleFresh) {
		velocity.x = 0.0f;
		velocity.y = 0.0f;
		flowRecentlyUsable = false;
		flowCtrlUsingFlow = false;
		flowPositionGateOpen = false;
		return;
	}
	if (!flowAvailable) {
		flowRecentlyUsable = false;
		flowCtrlUsingFlow = false;
		flowPositionGateOpen = false;
		return;
	}

	bool usableFlow = flowAvailable && !flowSpikeRejected;

	if (usableFlow && newFlowSample) {
		flowInnov.x = flowFilteredBodyVel.x - velocity.x;
		flowInnov.y = flowFilteredBodyVel.y - velocity.y;
		velocity.x += constrain(flowInnov.x, -flowInnovationLimit, flowInnovationLimit) * flowVelocitySmoothing;
		velocity.y += constrain(flowInnov.y, -flowInnovationLimit, flowInnovationLimit) * flowVelocitySmoothing;
		flowRecentlyUsable = true;
		flowCtrlUsingFlow = true;
	} else if (usableFlow && flowRecentlyUsable) {
		flowCtrlUsingFlow = true;
	} else if (newFlowSample) {
		velocity.x *= 0.80f;
		velocity.y *= 0.80f;
		flowRecentlyUsable = false;
		flowCtrlUsingFlow = false;
	}

	if (!flowAirborne) {
		if (abs(velocity.x) < flowVelocityZeroDeadband) velocity.x = 0.0f;
		if (abs(velocity.y) < flowVelocityZeroDeadband) velocity.y = 0.0f;
	}

	// Position is integrated once per valid optical-flow packet, never at IMU-loop rate.
	if (!flowCtrlUsingFlow) {
		flowPositionGateOpen = false;
		return;
	}

	// TOF is the direct height measurement. The integrated vertical state is too
	// noisy during takeoff to be a hard horizontal-position gate.
	bool positionHeightStable = tofHealthy &&
		opticalFlowHeight > 0.05f && opticalFlowHeight < 6.0f;
	bool positionTiltStable = abs(up.z) > flowTiltCosMin;
	bool positionFlowStable = !flowSpikeRejected;

	flowPositionGateOpen = positionHeightStable && positionTiltStable && positionFlowStable;
	if (!newFlowSample || !flowPositionGateOpen) return;

	Vector worldVel = worldVelocityEstimate();
	if (abs(worldVel.x) < flowPositionZeroDeadband) worldVel.x = 0.0f;
	if (abs(worldVel.y) < flowPositionZeroDeadband) worldVel.y = 0.0f;
	position.x += worldVel.x * opticalFlowSampleDt;
	position.y += worldVel.y * opticalFlowSampleDt;
}
