npu-ius-lab/open32drone/firmware/quaternion.h

// Copyright (c) 2023 Oleg Kalachev <okalachev@gmail.com>
// Repository: https://github.com/okalachev/flix

// Lightweight rotation quaternion library

#pragma once

#include "vector.h"

class Quaternion : public Printable {
public:
	float w, x, y, z;

	Quaternion(): w(1), x(0), y(0), z(0) {};

	Quaternion(float w, float x, float y, float z): w(w), x(x), y(y), z(z) {};

	static Quaternion fromAxisAngle(const Vector& axis, float angle) {
		float halfAngle = angle * 0.5;
		float sin2 = sin(halfAngle);
		float cos2 = cos(halfAngle);
		float sinNorm = sin2 / axis.norm();
		return Quaternion(cos2, axis.x * sinNorm, axis.y * sinNorm, axis.z * sinNorm);
	}

	static Quaternion fromRotationVector(const Vector& rotation) {
		if (rotation.zero()) {
			return Quaternion();
		}
		return Quaternion::fromAxisAngle(rotation, rotation.norm());
	}

	static Quaternion fromEuler(const Vector& euler) {
		float cx = cos(euler.x / 2);
		float cy = cos(euler.y / 2);
		float cz = cos(euler.z / 2);
		float sx = sin(euler.x / 2);
		float sy = sin(euler.y / 2);
		float sz = sin(euler.z / 2);

		return Quaternion(
			cx * cy * cz + sx * sy * sz,
			sx * cy * cz - cx * sy * sz,
			cx * sy * cz + sx * cy * sz,
			cx * cy * sz - sx * sy * cz);
	}

	bool finite() const {
		return isfinite(w) && isfinite(x) && isfinite(y) && isfinite(z);
	}

	bool valid() const {
		return finite();
	}

	bool invalid() const {
		return !valid();
	}

	void invalidate() {
		w = NAN;
		x = NAN;
		y = NAN;
		z = NAN;
	}


	float norm() const {
		return sqrt(w * w + x * x + y * y + z * z);
	}

	void normalize() {
		float n = norm();
		w /= n;
		x /= n;
		y /= n;
		z /= n;
	}

	Vector toEuler() const {
		// https://github.com/ros/geometry2/blob/589caf083cae9d8fae7effdb910454b4681b9ec1/tf2/include/tf2/impl/utils.h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
		Vector euler;
		float sqx = x * x;
		float sqy = y * y;
		float sqz = z * z;
		float sqw = w * w;
		// Cases derived from https://orbitalstation.wordpress.com/tag/quaternion/
		float sarg = -2 * (x * z - w * y) / (sqx + sqy + sqz + sqw);
		if (sarg <= -0.99999) {
			euler.x = 0;
			euler.y = -0.5 * PI;
			euler.z = -2 * atan2(y, x);
		} else if (sarg >= 0.99999) {
			euler.x = 0;
			euler.y = 0.5 * PI;
			euler.z = 2 * atan2(y, x);
		} else {
			euler.x = atan2(2 * (y * z + w * x), sqw - sqx - sqy + sqz);
			euler.y = asin(sarg);
			euler.z = atan2(2 * (x * y + w * z), sqw + sqx - sqy - sqz);
		}
		return euler;
	}

	float getRoll() const {
		return toEuler().x;
	}

	float getPitch() const {
		return toEuler().y;
	}

	float getYaw() const {
		return toEuler().z;
	}

	Quaternion operator * (const Quaternion& q) const {
		return Quaternion(
			w * q.w - x * q.x - y * q.y - z * q.z,
			w * q.x + x * q.w + y * q.z - z * q.y,
			w * q.y + y * q.w + z * q.x - x * q.z,
			w * q.z + z * q.w + x * q.y - y * q.x);
	}

	Quaternion inversed() const {
		float normSqInv = 1 / (w * w + x * x + y * y + z * z);
		return Quaternion(
			w * normSqInv,
			-x * normSqInv,
			-y * normSqInv,
			-z * normSqInv);
	}

	Vector conjugateInversed(const Vector& v) const {
		Quaternion qv(0, v.x, v.y, v.z);
		Quaternion res = inversed() * qv * (*this);
		return Vector(res.x, res.y, res.z);
	}

	// Rotate quaternion by quaternion
	static Quaternion rotate(const Quaternion& a, const Quaternion& b, const bool normalize = true) {
		Quaternion rotated = a * b;
		if (normalize) {
			rotated.normalize();
		}
		return rotated;
	}

	// Rotate vector by quaternion
	static Vector rotateVector(const Vector& v, const Quaternion& q) {
		return q.conjugateInversed(v);
	}

	size_t printTo(Print& p) const {
		size_t r = 0;
		r += p.print(w, 15) + p.print(" ");
		r += p.print(x, 15) + p.print(" ");
		r += p.print(y, 15) + p.print(" ");
		r += p.print(z, 15);
		return r;
	}
};
