npu-ius-lab/open32drone/firmware/source_identity.h

#pragma once

// SHA-256 over every firmware source file except this generated identity file.
// tests/test_repository_contract.py defines the canonical ordering and framing.
#define OPEN32DRONE_FIRMWARE_SOURCE_SHA256 "ea131c7293e21d053056bdaf93ce2d7324f6840acaa946e6365335ba7e0e1bd9"
