npu-ius-lab/open32drone/(commit log)

2026-09-05 update tutorial
    [open32drone-frame.3mf, open32drone-frame.stp]
2026-09-22 Sync featdemo updates while preserving layout and original READMEs
    Import ROS readiness, flight control, hardware, release and documentation updates. Consolidate guides into bilingual tutorials and align English with the revised Chinese text.
    [open32drone-frame.3mf, open32drone-frame.stp]
2026-09-30 Sync current Open32Drone source, tutorials, and repository layout
    [open32drone-frame.3mf, open32drone-frame.stp]
2026-09-30 Revert repository source and layout synchronization
    [open32drone-frame.3mf, open32drone-frame.stp]
2026-09-30 Restore reviewed Open32Drone source, tutorials, and layout
    [open32drone-frame.3mf, open32drone-frame.stp]
2026-10-21 docs: clarify power selection and IMU assembly in both languages
2026-10-24 docs: add log-assisted tuning guidance and highlight assembly checks
