npu-ius-lab/open32drone/(notices)

Notices in the files:
README.md:
[(https://img.shields.io/badge/License-Apach
License: Apache 2.0
docs/project/third-party.md:
Frame print profile | [MakerWorld](https://makerworld.com.cn/zh/models/2922108-open32drone-wu-ren-ji-8520kong-xin-bei-ji-jia-ros2#profileId-3425842): the page lists CC BY-NC 4.0. Retain attribution and follow the model's terms.
docs/project/third-party.zh-CN.md:
机架打印配置 | [MakerWorld](https://makerworld.com.cn/zh/models/2922108-open32drone-wu-ren-ji-8520kong-xin-bei-ji-jia-ros2#profileId-3425842)：页面标注 CC BY-NC 4.0，使用时保留来源署名并遵守模型条款。
